elekras/fs65sbc-6502-sbc/bin/65term.png

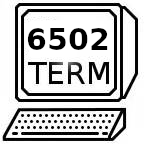
bin/65term.png
