elekras/fs65sbc-6502-sbc/hw/fs65sbc-3.0-bot.pdf

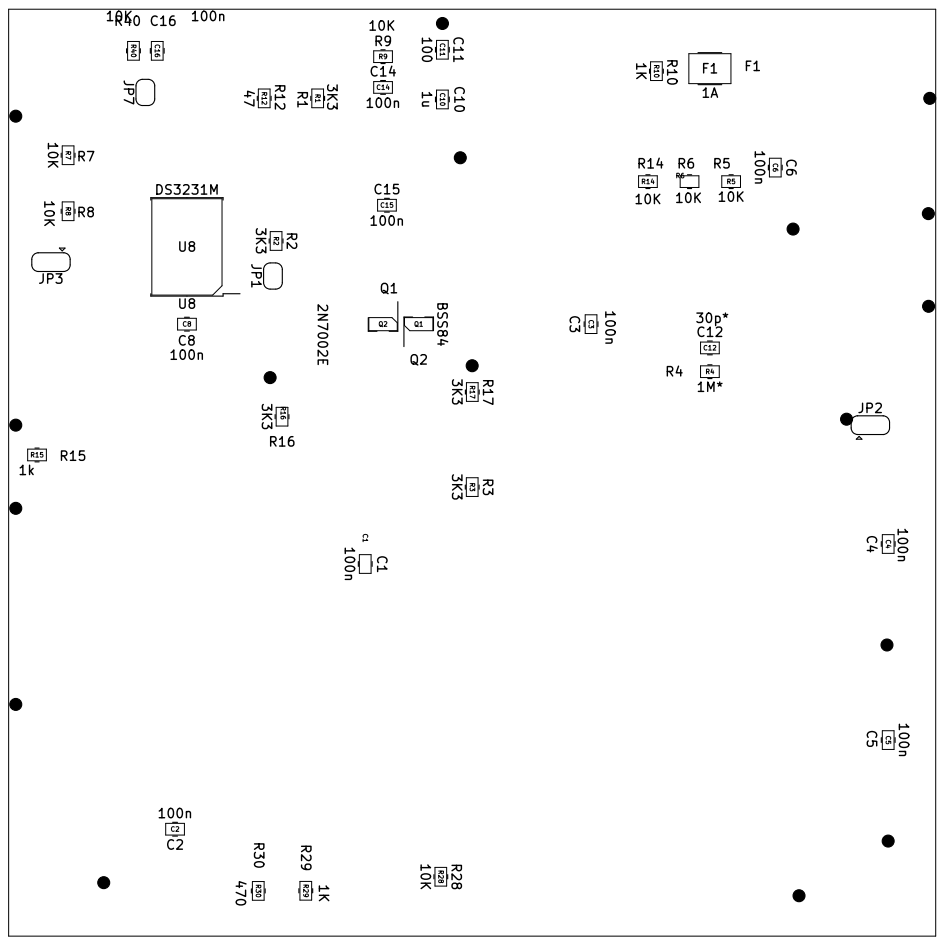
[picture p9: page 1]
