elekras/fs65sbc-6502-sbc/hw/fs65sbc-3.0-top.pdf

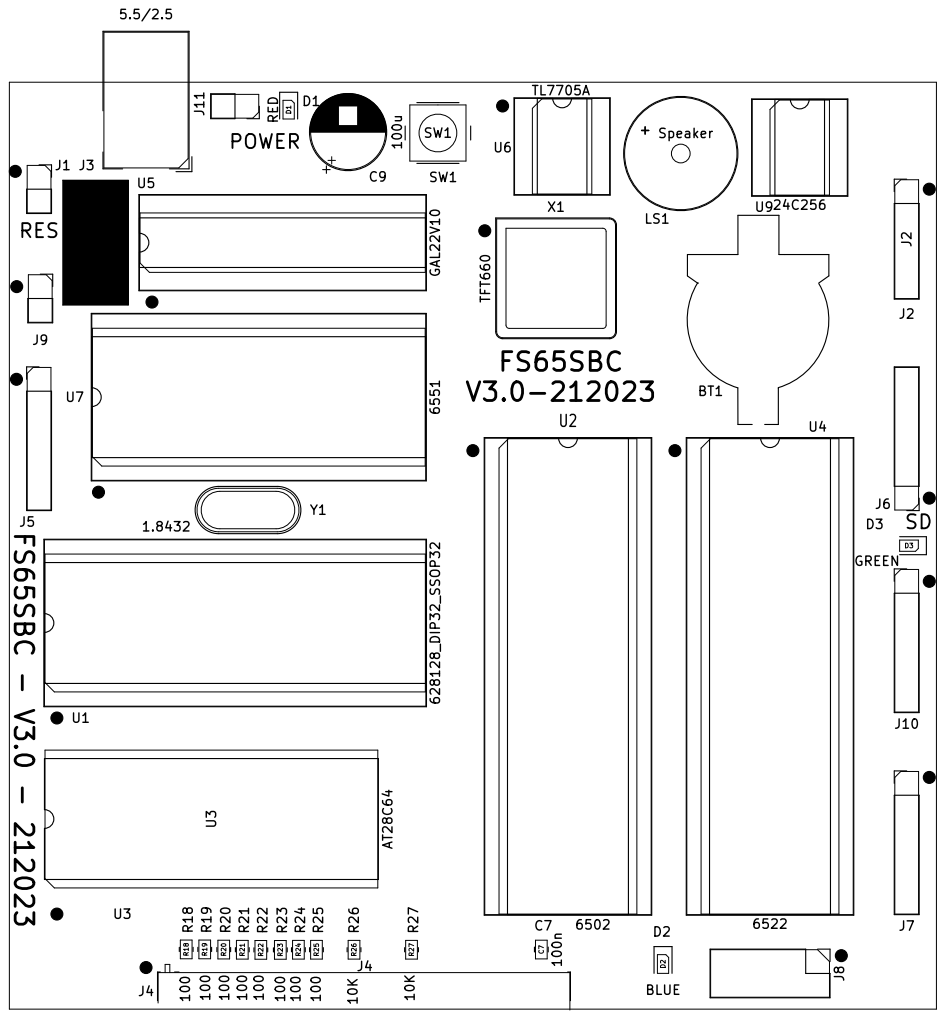
[picture p10: page 1]
