elekras/fs65sbc-6502-sbc/hw/fs65sbc-3.0.pdf

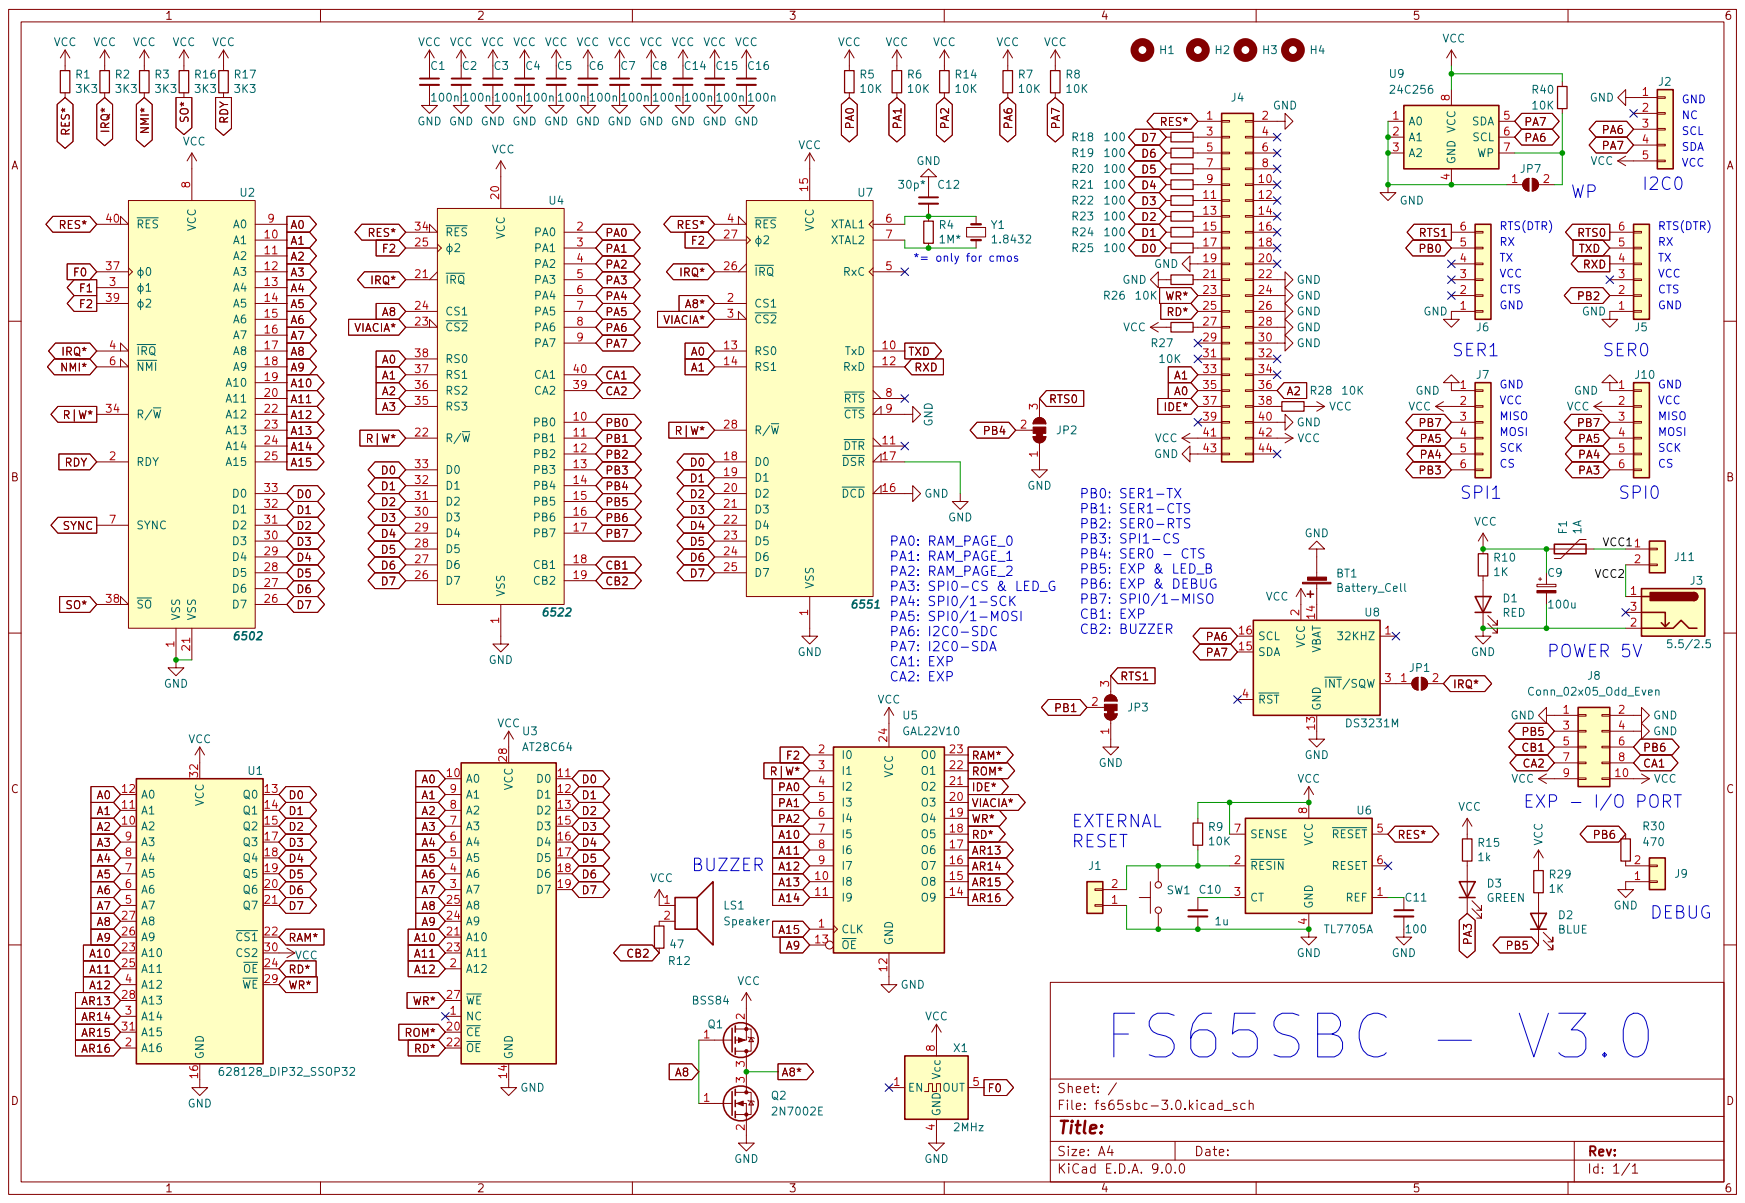
[picture p11: page 1]
