elekras/fs65sbc-6502-sbc/hw/fs65sbc-3.0.kicad_pcb

## KiCad design hw/fs65sbc-3.0.kicad_pcb (2025-03-25)

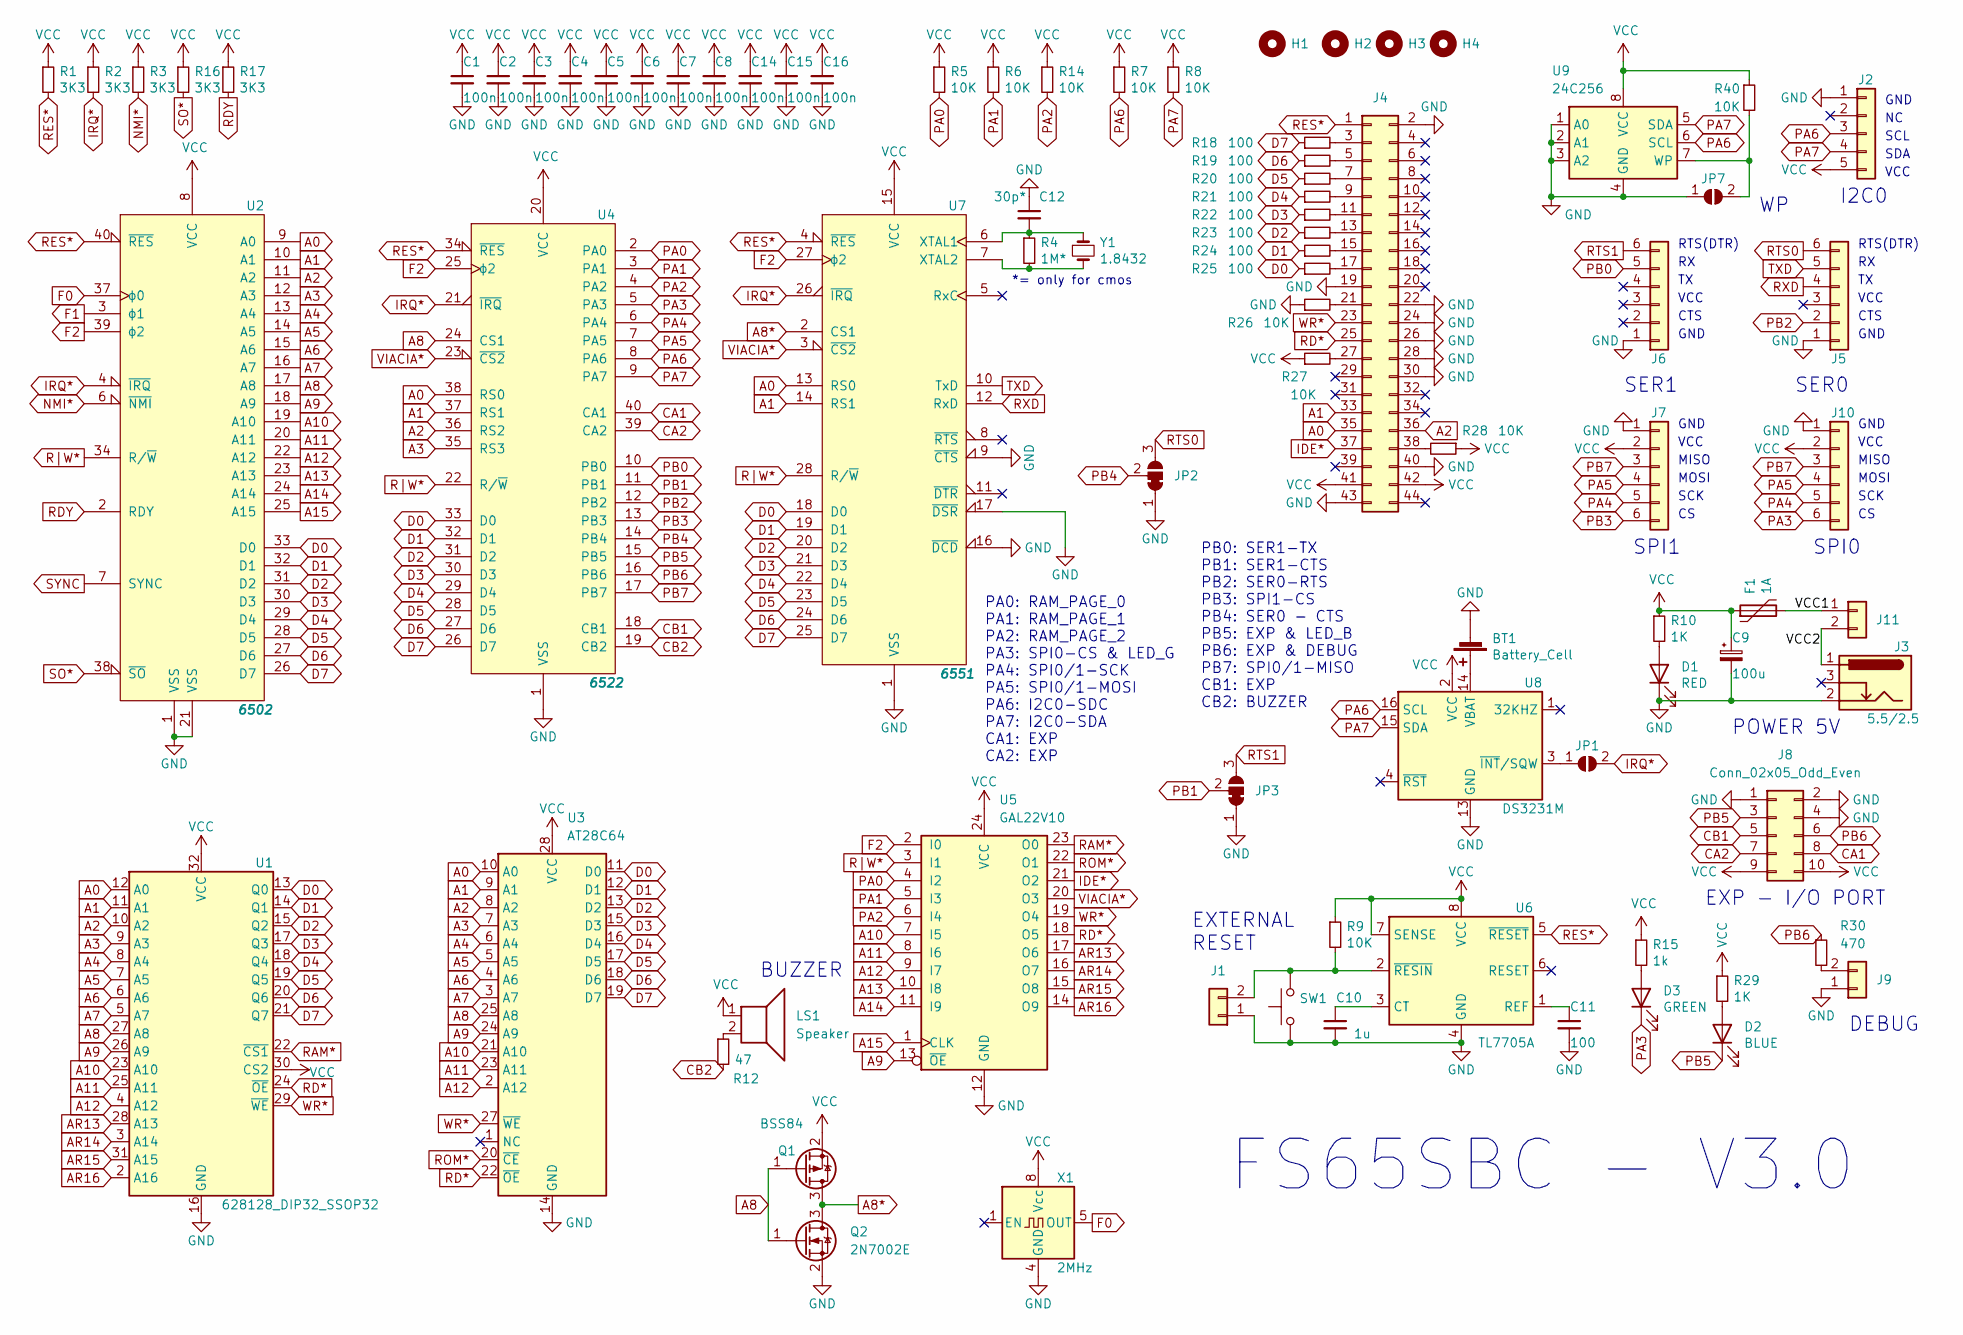
[picture p12: schematic fs65sbc-3.0.kicad_sch]

Parts:
BT1: Battery_Cell; BATTERY_HOLDER_CR2012
C1, C2, C3, C4, C5, C6, C7, C8, C14, C15, C16: 100n; C_0805_2012Metric_Pad1.18x1.45mm_HandSolder
C9: 100u; CP_Radial_D8.0mm_P3.50mm
C10: 1u; C_0805_2012Metric_Pad1.18x1.45mm_HandSolder
C11: 100; C_0805_2012Metric_Pad1.18x1.45mm_HandSolder
C12: 30p*; C_0805_2012Metric_Pad1.18x1.45mm_HandSolder
D1: RED; LED_0805_2012Metric_Pad1.15x1.40mm_HandSolder
D2: BLUE; LED_0805_2012Metric_Pad1.15x1.40mm_HandSolder
D3: GREEN; LED_0805_2012Metric_Pad1.15x1.40mm_HandSolder
F1: 1A; Fuse_1812_4532Metric_Castellated
H1, H2, H3, H4: MountingHole; MountingHole_3.2mm_M3_Pad
J1, J9, J11: Conn_01x02; PinSocket_1x02_P2.54mm_Vertical
J2: Conn_01x05; PinHeader_1x05_P2.54mm_Vertical
J3: 5.5/2.5; BarrelJack_Wuerth_6941xx301002
J4: Conn_02x22_Odd_Even; Edge_2x22_P2.00mm_SMD
J5, J6, J7, J10: Conn_01x05; PinHeader_1x06_P2.54mm_Vertical
J8: Conn_02x05_Odd_Even; PinHeader_2x05_P2.54mm_Vertical
JP1, JP7: SolderJumper_2_Open; SolderJumper-2_P1.3mm_Open_RoundedPad1.0x1.5mm
JP2, JP3: SolderJumper_3_Bridged12; SolderJumper-3_P1.3mm_Open_RoundedPad1.0x1.5mm
LS1: Speaker; Buzzer_12x9.5RM7.6
Q1: BSS84; SOT-23_Handsoldering
Q2: 2N7002E; SOT-23_Handsoldering
R1, R2, R3, R16, R17: 3K3; R_0805_2012Metric_Pad1.20x1.40mm_HandSolder
R4: 1M*; R_0805_2012Metric_Pad1.20x1.40mm_HandSolder
R5, R6, R7, R8, R9, R14, R26, R27, R28, R40: 10K; R_0805_2012Metric_Pad1.20x1.40mm_HandSolder
R10, R29: 1K; R_0805_2012Metric_Pad1.20x1.40mm_HandSolder
R12: 47; R_0805_2012Metric_Pad1.20x1.40mm_HandSolder
R15: 1k; R_0805_2012Metric_Pad1.20x1.40mm_HandSolder
R18, R19, R20, R21, R22, R23, R24, R25: 100; R_0805_2012Metric_Pad1.20x1.40mm_HandSolder
R30: 470; R_0805_2012Metric_Pad1.20x1.40mm_HandSolder
SW1: SW_Push; SW_PUSH_6mm_H4.3mm
U1: 628128_DIP32_SSOP32; DIP-32_W15.24mm_Socket
U2: 6502; DIP-40_W15.24mm_Socket
U3: AT28C64; DIP-28_W15.24mm
U4: 6522; DIP-40_W15.24mm_Socket
U5: GAL22V10; DIP-24_W7.62mm_Socket
U6: TL7705A; DIP-8_W7.62mm_Socket
U7: 6551; DIP-28_W15.24mm_Socket
U8: DS3231M; SOIC-16W_7.5x10.3mm_P1.27mm
U9: 24C256; DIP-8_W7.62mm_Socket
X1: 2MHz; Oscillator_DIP-8
Y1: 1.8432; Crystal_HC49-U_Vertical

Connections:
/VCC1: F1.2, J11.1
/VCC2: J3.1, J11.2
A0: J4.35, U1.12 (A0), U2.9 (A0), U3.10 (A0), U4.38 (RS0), U7.13 (RS0)
A1: J4.33, U1.11 (A1), U2.10 (A1), U3.9 (A1), U4.37 (RS1), U7.14 (RS1)
A2: J4.36, U1.10 (A2), U2.11 (A2), U3.8 (A2), U4.36 (RS2)
A3: U1.9 (A3), U2.12 (A3), U3.7 (A3), U4.35 (RS3)
A4: U1.8 (A4), U2.13 (A4), U3.6 (A4)
A5: U1.7 (A5), U2.14 (A5), U3.5 (A5)
A6: U1.6 (A6), U2.15 (A6), U3.4 (A6)
A7: U1.5 (A7), U2.16 (A7), U3.3 (A7)
A8: Q1.1 (G), Q2.1 (G), U1.27 (A8), U2.17 (A8), U3.25 (A8), U4.24 (CS1)
A8*: Q1.3 (D), Q2.3 (D), U7.2 (CS1)
A9: U1.26 (A9), U2.18 (A9), U3.24 (A9), U5.13 (~OE)
A10: U1.23 (A10), U2.19 (A10), U3.21 (A10), U5.7 (I5)
A11: U1.25 (A11), U2.20 (A11), U3.23 (A11), U5.8 (I6)
A12: U1.4 (A12), U2.22 (A12), U3.2 (A12), U5.9 (I7)
A13: U2.23 (A13), U5.10 (I8)
A14: U2.24 (A14), U5.11 (I9)
A15: U2.25 (A15), U5.1 (CLK)
AR13: U1.28 (A13), U5.17 (O6)
AR14: U1.3 (A14), U5.16 (O7)
AR15: U1.31 (A15), U5.15 (O8)
AR16: U1.2 (A16), U5.14 (O9)
CA1: J8.8, U4.40 (CA1)
CA2: J8.7, U4.39 (CA2)
CB1: J8.5, U4.18 (CB1)
CB2: R12.2, U4.19 (CB2)
D0: R25.1, U1.13 (Q0), U2.33 (D0), U3.11 (D0), U4.33 (D0), U7.18 (D0)
D1: R24.1, U1.14 (Q1), U2.32 (D1), U3.12 (D1), U4.32 (D1), U7.19 (D1)
D2: R23.1, U1.15 (Q2), U2.31 (D2), U3.13 (D2), U4.31 (D2), U7.20 (D2)
D3: R22.1, U1.17 (Q3), U2.30 (D3), U3.15 (D3), U4.30 (D3), U7.21 (D3)
D4: R21.1, U1.18 (Q4), U2.29 (D4), U3.16 (D4), U4.29 (D4), U7.22 (D4)
D5: R20.1, U1.19 (Q5), U2.28 (D5), U3.17 (D5), U4.28 (D5), U7.23 (D5)
D6: R19.1, U1.20 (Q6), U2.27 (D6), U3.18 (D6), U4.27 (D6), U7.24 (D6)
D7: R18.1, U1.21 (Q7), U2.26 (D7), U3.19 (D7), U4.26 (D7), U7.25 (D7)
F0: U2.37 (ϕ0), X1.5 (OUT)
F1: U2.3 (ϕ1)
F2: U2.39 (ϕ2), U4.25 (ϕ2), U5.2 (I0), U7.27 (ϕ2)
GND: BT1.2 (-), C1.2, C2.2, C3.2, C4.2, C5.2, C6.2, C7.2, C8.2, C9.2, C10.2, C11.2, C12.1, C14.2, C15.2, C16.2, D1.1 (K), J1.1, J2.1, J3.2, J4.2, J4.19, J4.22, J4.24, J4.26, J4.28, J4.30, J4.40, J4.43, J5.1, J6.1, J7.1, J8.1, J8.2, J8.4, J9.1, J10.1, JP2.1 (A), JP3.1 (A), JP7.1 (A), Q2.2 (S), R26.1, SW1.1, U1.16 (GND), U2.1 (VSS), U2.21 (VSS), U3.14 (GND), U4.1 (VSS), U5.12 (GND), U6.4 (GND), U7.1 (VSS), U7.9 (~CTS), U7.16 (~DCD), U7.17 (~DSR), U8.5 (GND), U8.6 (GND), U8.7 (GND), U8.8 (GND), U8.9 (GND), U8.10 (GND), U8.11 (GND), U8.12 (GND), U8.13 (GND), U9.1 (A0), U9.2 (A1), U9.3 (A2), U9.4 (GND), X1.4 (GND)
IDE*: J4.37, U5.21 (O2)
IRQ*: JP1.2 (B), R2.2, U2.4 (~IRQ), U4.21 (~IRQ), U7.26 (~IRQ)
NMI*: R3.2, U2.6 (~NMI)
unnamed: BT1.1 (+), U8.14 (VBAT)
unnamed: C10.1, U6.3 (CT)
unnamed: C11.1, U6.1 (REF)
unnamed: C12.2, R4.1, U7.6 (XTAL1), Y1.1
unnamed: D1.2 (A), R10.2
unnamed: D2.2 (A), R29.2
unnamed: D3.2 (A), R15.2
unnamed: J1.2, R9.2, SW1.2, U6.2 (~RESIN)
unnamed: J4.3, R18.2
unnamed: J4.5, R19.2
unnamed: J4.7, R20.2
unnamed: J4.9, R21.2
unnamed: J4.11, R22.2
unnamed: J4.13, R23.2
unnamed: J4.15, R24.2
unnamed: J4.17, R25.2
unnamed: J4.21, R26.2
unnamed: J4.27, R27.2
unnamed: J4.38, R28.2
unnamed: J9.2, R30.2
unnamed: JP1.1 (A), U8.3 (~INT/SQW)
unnamed: JP7.2 (B), R40.2, U9.7 (WP)
unnamed: LS1.2, R12.1
unnamed: R4.2, U7.7 (XTAL2), Y1.2
PA0: R5.2, U4.2 (PA0), U5.4 (I2)
PA1: R6.2, U4.3 (PA1), U5.5 (I3)
PA2: R14.2, U4.4 (PA2), U5.6 (I4)
PA3: D3.1 (K), J10.6, U4.5 (PA3)
PA4: J7.5, J10.5, U4.6 (PA4)
PA5: J7.4, J10.4, U4.7 (PA5)
PA6: J2.3, R7.2, U4.8 (PA6), U8.16 (SCL), U9.6 (SCL)
PA7: J2.4, R8.2, U4.9 (PA7), U8.15 (SDA), U9.5 (SDA)
PB0: J6.5, U4.10 (PB0)
PB1: JP3.2 (C), U4.11 (PB1)
PB2: J5.2, U4.12 (PB2)
PB3: J7.6, U4.13 (PB3)
PB4: JP2.2 (C), U4.14 (PB4)
PB5: D2.1 (K), J8.3, U4.15 (PB5)
PB6: J8.6, R30.1, U4.16 (PB6)
PB7: J7.3, J10.3, U4.17 (PB7)
RAM*: U1.22 (~CS1), U5.23 (O0)
RD*: J4.25, U1.24 (~OE), U3.22 (~OE), U5.18 (O5)
RDY: R17.2, U2.2 (RDY)
RES*: J4.1, R1.2, U2.40 (~RES), U4.34 (~RES), U6.5 (~RESET), U7.4 (~RES)
ROM*: U3.20 (~CE), U5.22 (O1)
RTS0: J5.6, JP2.3 (B)
RTS1: J6.6, JP3.3 (B)
RXD: J5.4, U7.12 (RxD)
R|W*: U2.34 (R/~W), U4.22 (R/~W), U5.3 (I1), U7.28 (R/~W)
SO*: R16.2, U2.38 (~SO)
SYNC: U2.7 (SYNC)
TXD: J5.5, U7.10 (TxD)
VCC: C1.1, C2.1, C3.1, C4.1, C5.1, C6.1, C7.1, C8.1, C9.1, C14.1, C15.1, C16.1, F1.1, J2.5, J4.41, J4.42, J7.2, J8.9, J8.10, J10.2, LS1.1, Q1.2 (S), R1.1, R2.1, R3.1, R5.1, R6.1, R7.1, R8.1, R9.1, R10.1, R14.1, R15.1, R16.1, R17.1, R27.1, R28.1, R29.1, R40.1, U1.30 (CS2), U1.32 (VCC), U2.8 (VCC), U3.28 (VCC), U4.20 (VCC), U5.24 (VCC), U6.7 (SENSE), U6.8 (VCC), U7.15 (VCC), U8.2 (VCC), U9.8 (VCC), X1.8 (Vcc)
VIACIA*: U4.23 (~CS2), U5.20 (O3), U7.3 (~CS2)
WR*: J4.23, U1.29 (~WE), U3.27 (~WE), U5.19 (O4)

Notes on the sheet:
PA0: RAM_PAGE_0 PA1: RAM_PAGE_1 PA2: RAM_PAGE_2 PA3: SPI0-CS & LED_G PA4: SPI0/1-SCK PA5: SPI0/1-MOSI PA6: I2C0-SDC PA7: I2C0-SDA CA1: EXP CA2: EXP
MOSI
DEBUG
VCC
RTS(DTR)
GND
*= only for cmos
SER1
SCK
FS65SBC - V3.0
BUZZER
EXP - I/O PORT
SPI1
CTS
PB0: SER1-TX PB1: SER1-CTS PB2: SER0-RTS PB3: SPI1-CS PB4: SER0 - CTS PB5: EXP & LED_B PB6: EXP & DEBUG PB7: SPI0/1-MISO CB1: EXP CB2: BUZZER
MISO
SER0
SDA
EXTERNAL RESET
I2C0
SCL
SPI0
POWER 5V

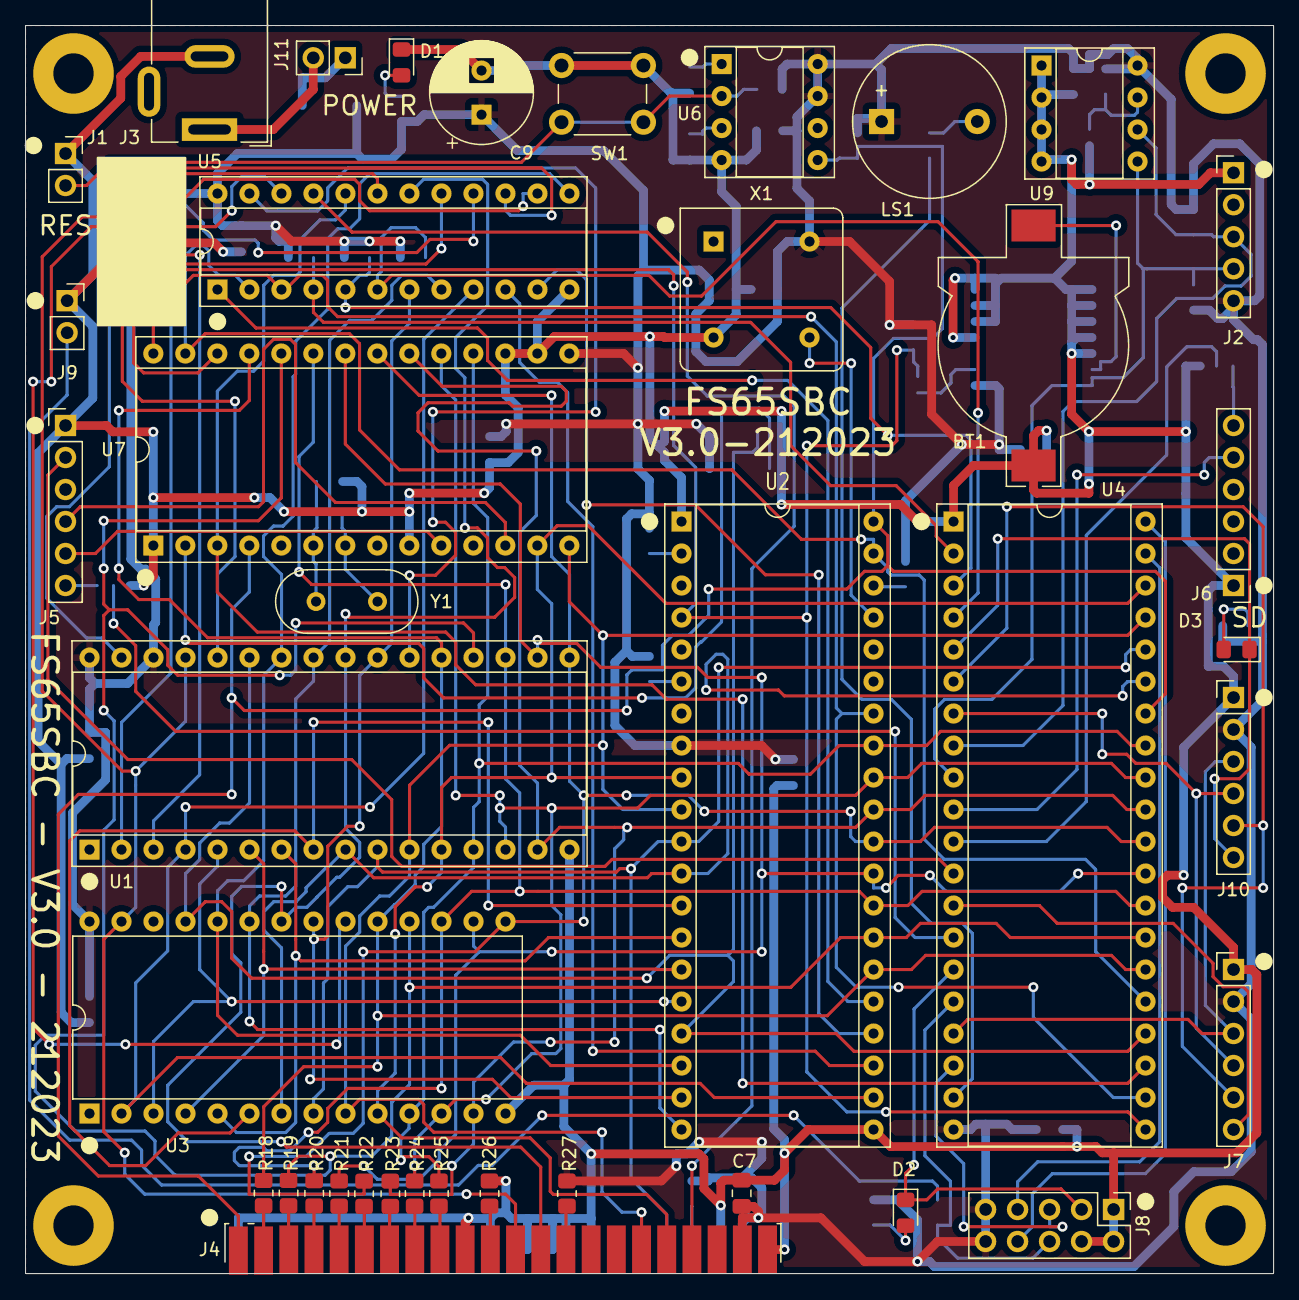
[picture p13: board fs65sbc-3.0.kicad_pcb from above]

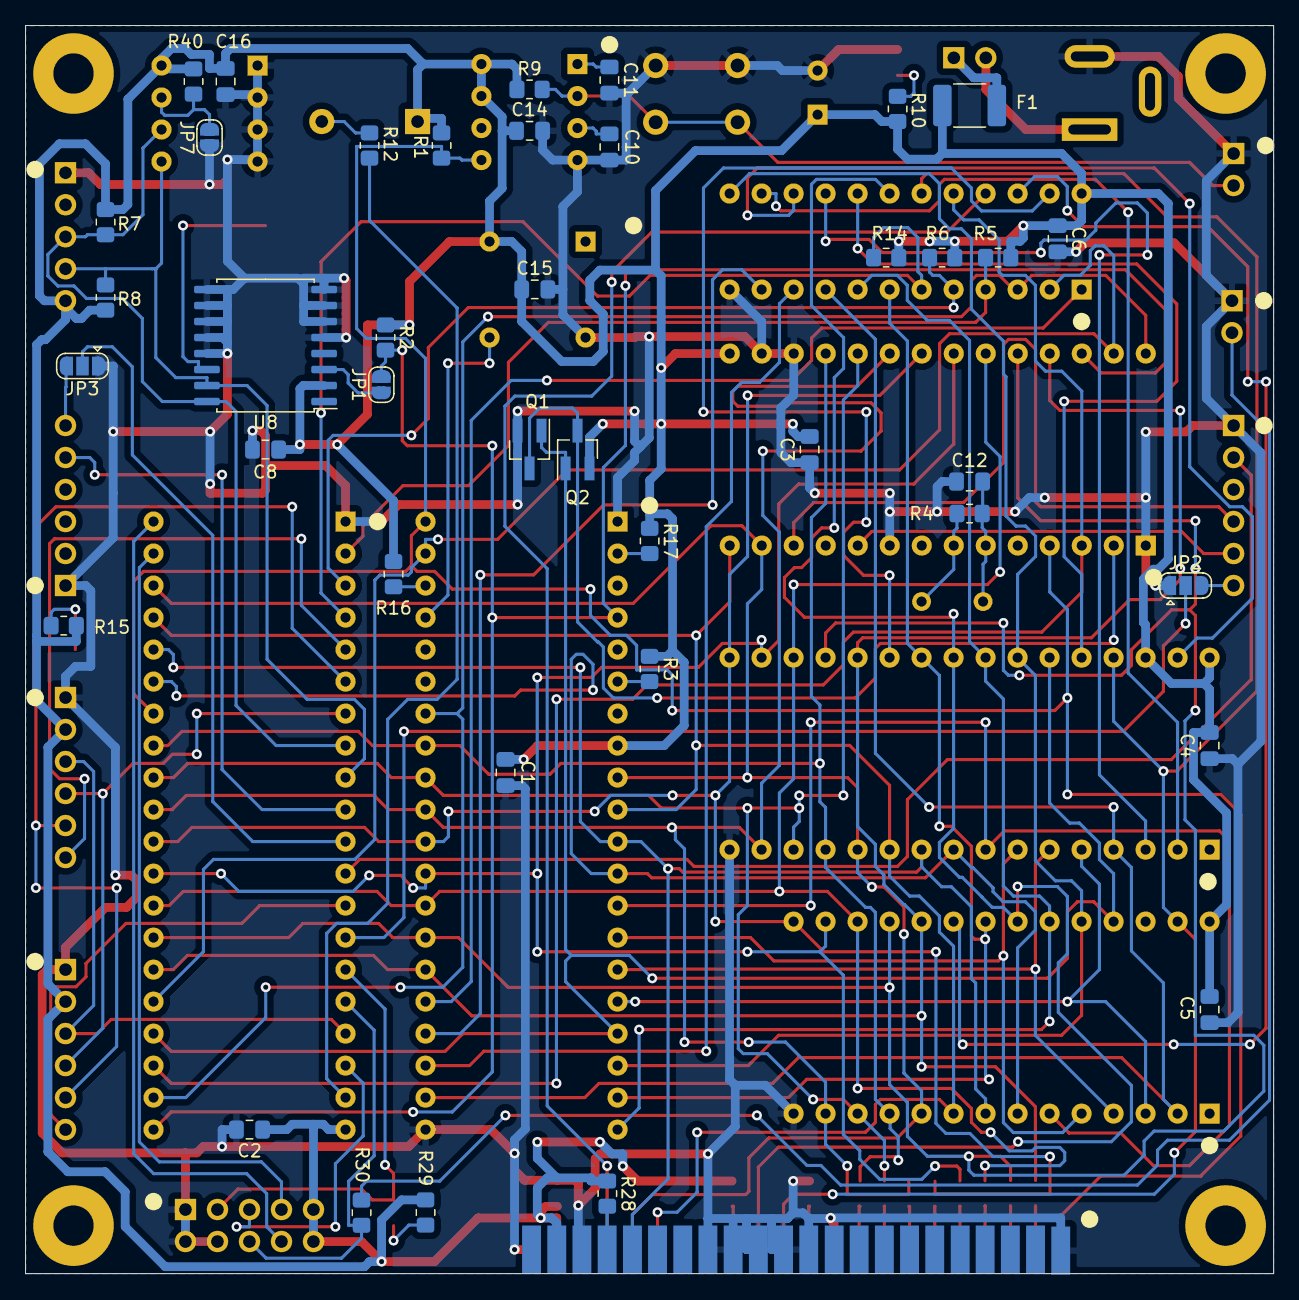
[picture p14: board fs65sbc-3.0.kicad_pcb from below]

Board: 2 copper layers, 99.1 x 99.1 mm, 83 parts (40 on the bottom side), 95 nets.
